AlexanderKoenig15/Komplexe-Leistung/Expose Vorlage.docx

Alexander König 11d 13.09.2021

Expose

Thema der Arbeit | Bemerkungen
Ziel der Arbeit
Arbeitsschritte mit Zeitplan
Inhaltliche Gliederung
Hinweise des Fachlehrers
Bestätigung des Fachlehrers
Datum und Unterschrift:
Datum:
Unterschrift:
