AlexanderKoenig15/Komplexe-Leistung/Modelle/Wandsensor Gehäuse.stl

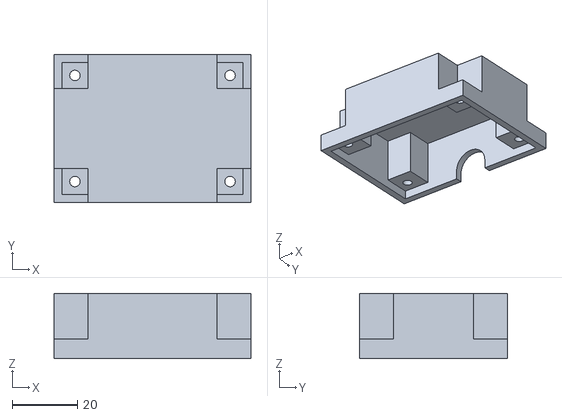
[picture p10: CAD file, 2022-01-17]
Modelle/Wandsensor Gehäuse.stl
60.3 x 45.3 x 20.0
