AlexanderKoenig15/Komplexe-Leistung/Modelle/Kabelklemme für 4 Pin Klemme.stl

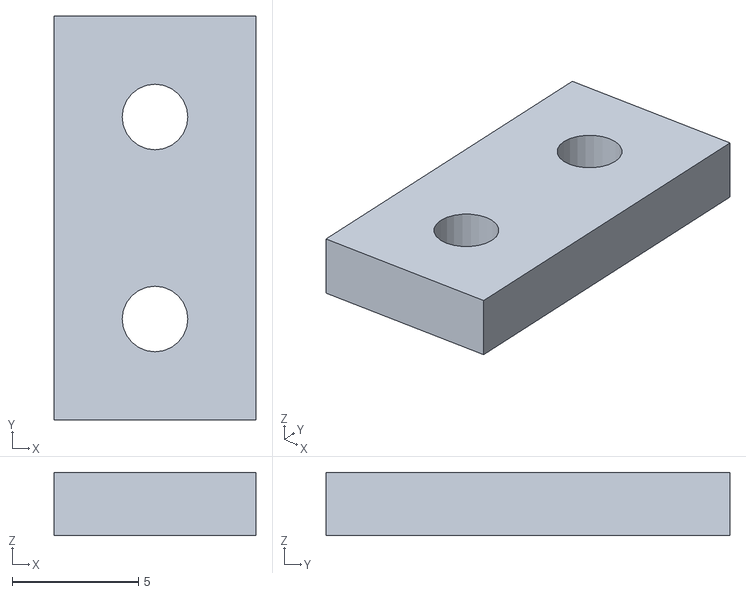
[picture p11: CAD file, 2022-01-10]
Modelle/Kabelklemme für 4 Pin Klemme.stl
8.00 x 16.0 x 2.50
