AlexanderKoenig15/Komplexe-Leistung/Modelle/Oberes Gehäuse.stl

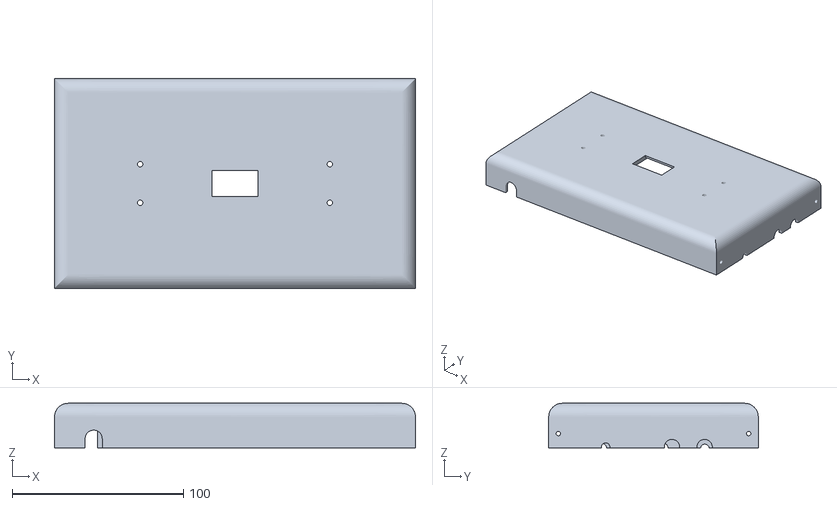
[picture p12: CAD file, 2022-01-10]
Modelle/Oberes Gehäuse.stl
210.8 x 122.4 x 26.0
