AlexanderKoenig15/Komplexe-Leistung/Modelle/Kabelklemme für 2 Pin Klemme.stl

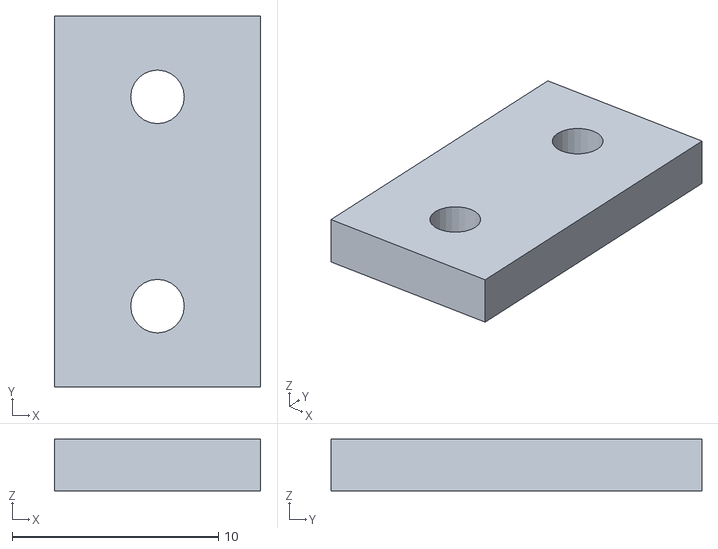
[picture p13: CAD file, 2022-01-10]
Modelle/Kabelklemme für 2 Pin Klemme.stl
10.0 x 18.0 x 2.50
