AlexanderKoenig15/Komplexe-Leistung/Modelle/Oberes Gehäuse Griff.stl

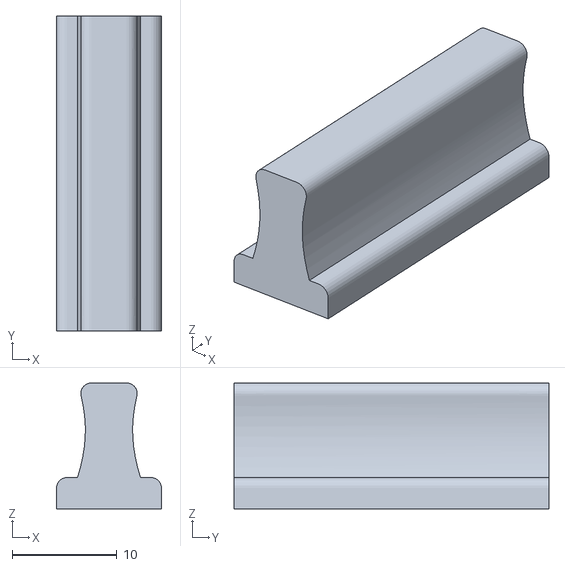
[picture p14: CAD file, 2022-01-10]
Modelle/Oberes Gehäuse Griff.stl
10.0 x 30.0 x 12.0
