AlexanderKoenig15/Komplexe-Leistung/Modelle/Unteres Gehäuse.stl

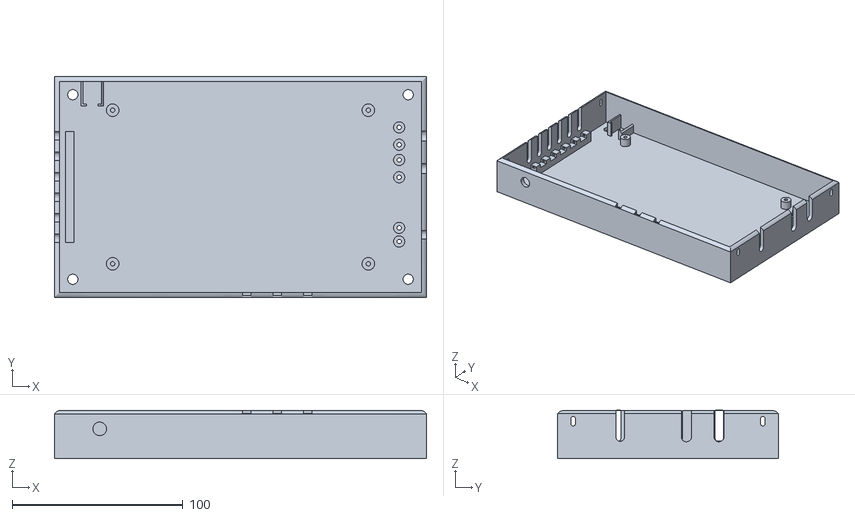
[picture p15: CAD file, 2022-01-10]
Modelle/Unteres Gehäuse.stl
218.0 x 129.6 x 28.2
