AlexanderKoenig15/Komplexe-Leistung/(list of files, cad)

Other CAD files:
Modelle/Kabelklemme für 2 Pin Klemme.dwg
Modelle/Kabelklemme für 4 Pin Klemme.dwg
Modelle/Oberes Gehäuse Griff.dwg
Modelle/Oberes Gehäuse.dwg
Modelle/Unteres Gehäuse.dwg
Modelle/Wandsensor Gehäuse.dwg
