AlexanderKoenig15/Komplexe-Leistung/Skizzen/Schaltplan/Schaltplan.kicad_pcb

## KiCad design Skizzen/Schaltplan/Schaltplan.kicad_pcb (2022-01-10)

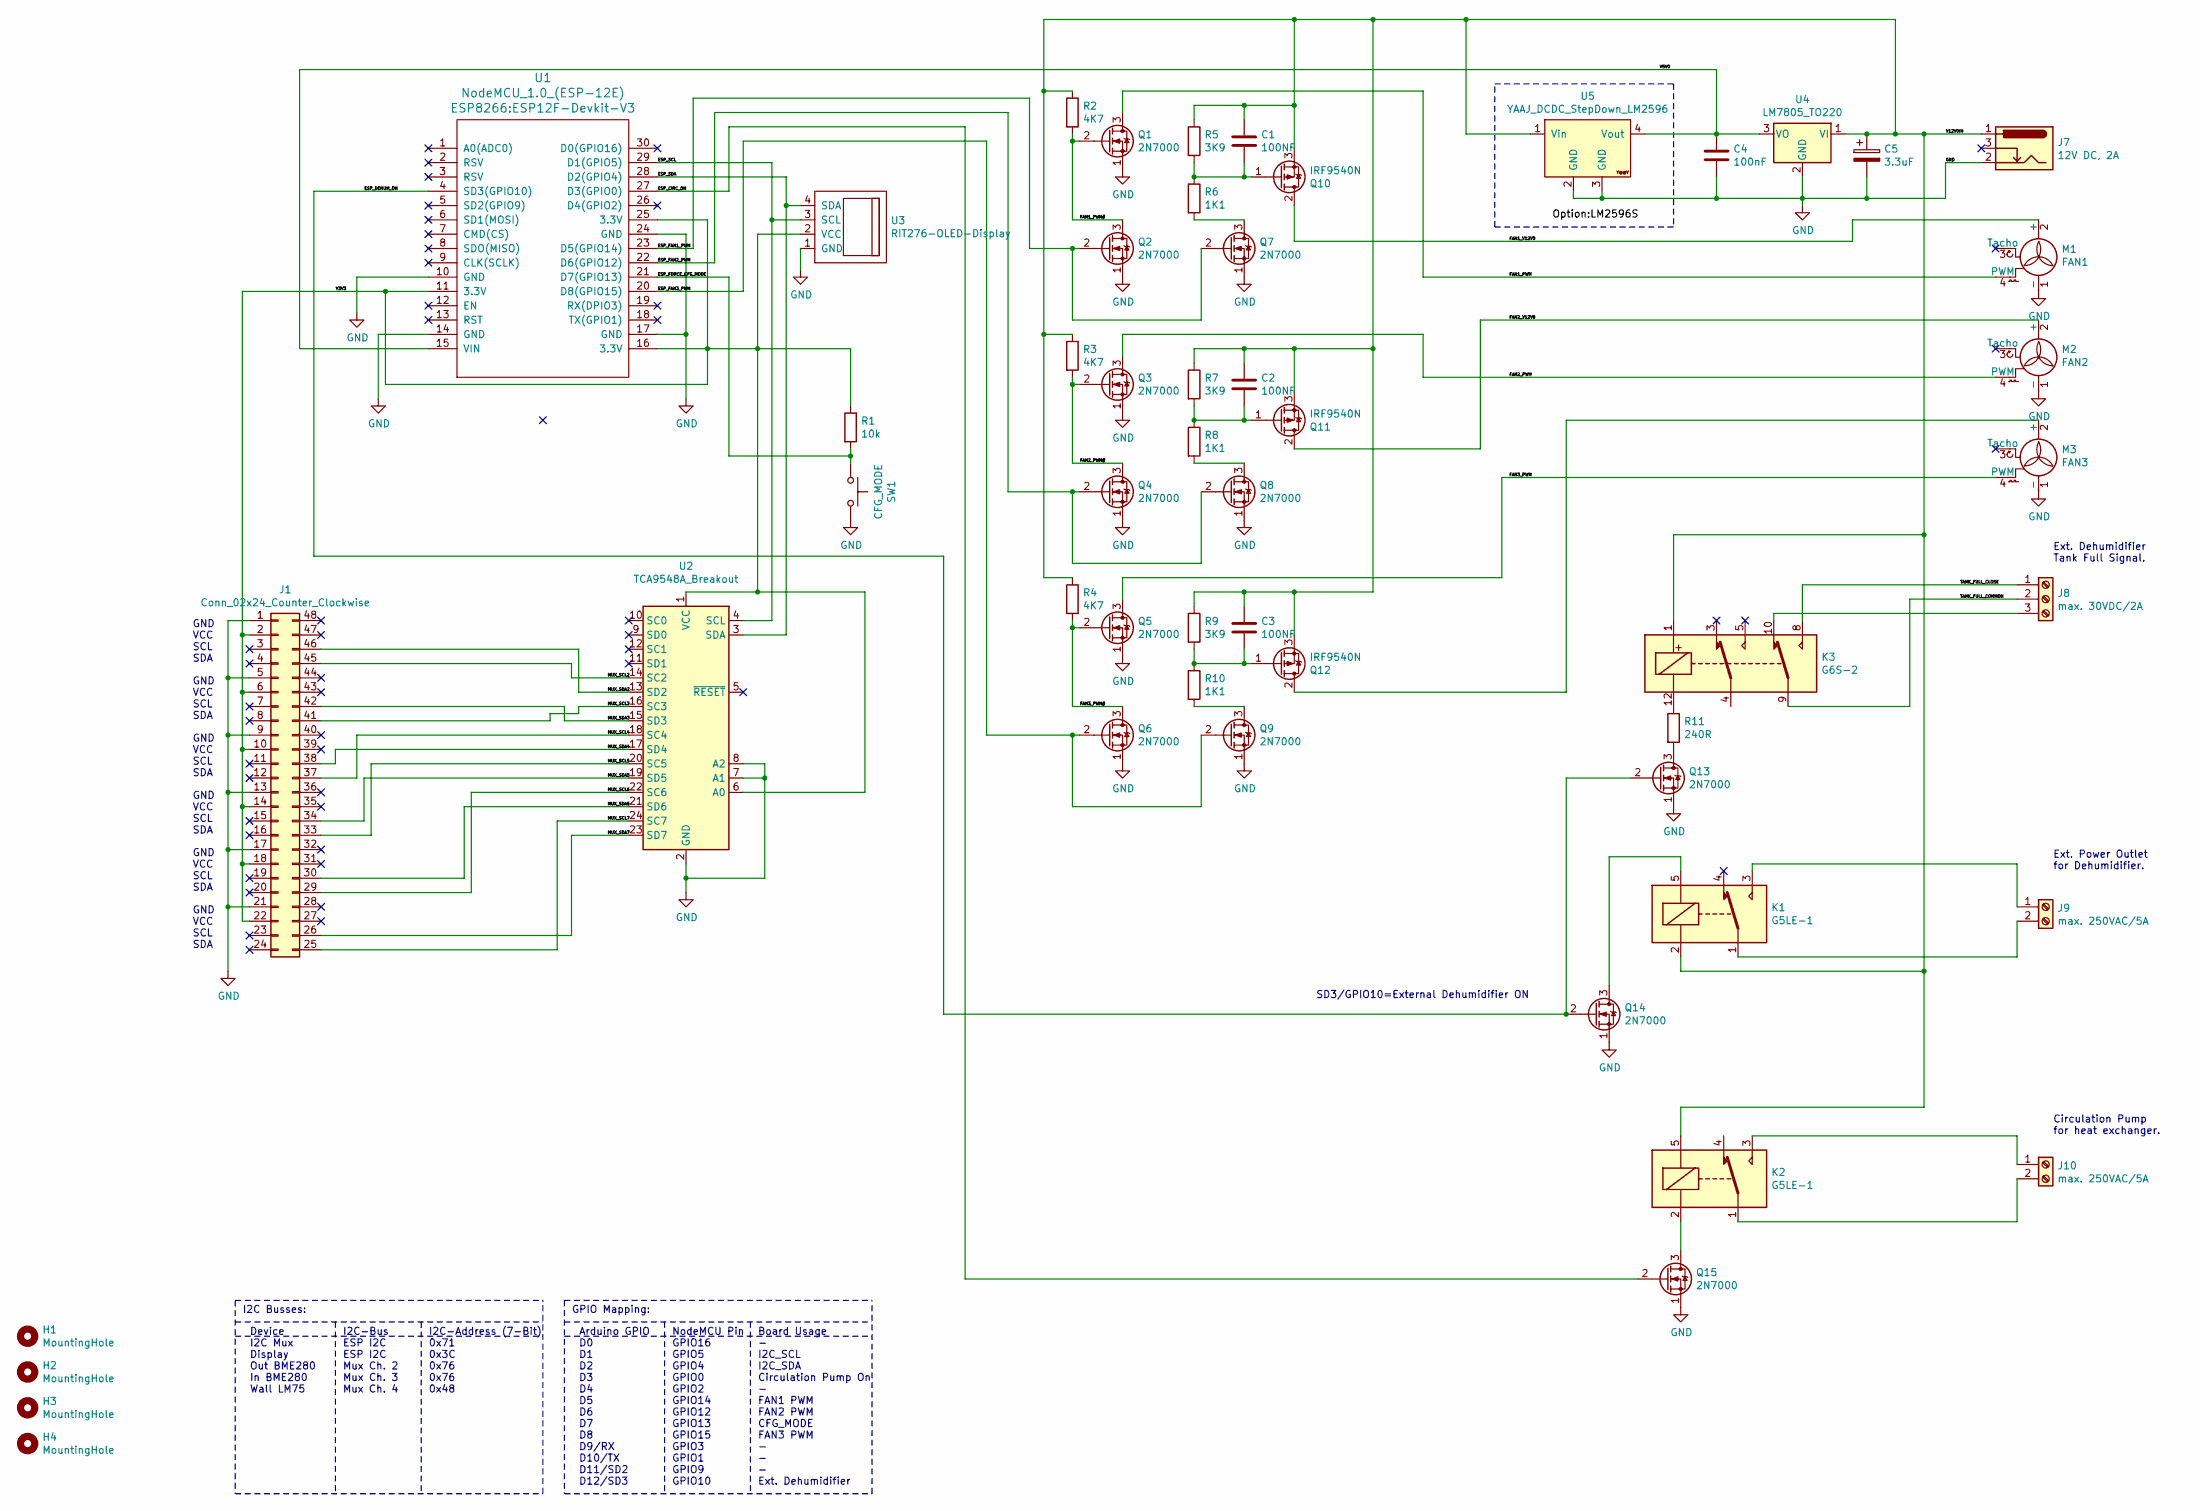
[picture p16: schematic Schaltplan.sch, Kellerlüftung mit ESP8266, Schaltplan]

Parts:
C1, C2, C3: 100NF; C_Disc_D4.3mm_W1.9mm_P5.00mm
C4: 100nF; C_Disc_D4.3mm_W1.9mm_P5.00mm
C5: 3.3uF; CP_Radial_Tantal_D4.5mm_P5.00mm
H1, H2, H3, H4: MountingHole; MountingHole_3.2mm_M3
J1: Conn_02x24_Counter_Clockwise; FFKDSH-2,54_24
J7: 12V DC, 2A; PinHeader_1x03_P2.54mm_Vertical
J8: max. 30VDC/2A; TerminalBlock_RND_205-00002_1x03_P5.00mm_Horizontal
J9, J10: max. 250VAC/5A; TerminalBlock_RND_205-00001_1x02_P5.00mm_Horizontal
K1, K2: G5LE-1; Relay_SPDT_Omron-G5LE-1
K3: G6S-2; Relay_DPDT_Omron_G6S-2
M1: FAN1; PinSocket_1x04_P2.54mm_Vertical
M2: FAN2; PinSocket_1x04_P2.54mm_Vertical
M3: FAN3; PinSocket_1x04_P2.54mm_Vertical
Q1, Q2, Q3, Q4, Q5, Q6, Q7, Q8, Q9, Q13, Q14, Q15: 2N7000; TO-92_Inline
Q10, Q11, Q12: IRF9540N; TO-220-3_Vertical
R1: 10k; R_Axial_DIN0204_L3.6mm_D1.6mm_P2.54mm_Vertical
R2, R3, R4: 4K7; R_Axial_DIN0204_L3.6mm_D1.6mm_P2.54mm_Vertical
R5, R7, R9: 3K9; R_Axial_DIN0204_L3.6mm_D1.6mm_P2.54mm_Vertical
R6, R8, R10: 1K1; R_Axial_DIN0204_L3.6mm_D1.6mm_P7.62mm_Horizontal
R11: 240R; R_Axial_DIN0204_L3.6mm_D1.6mm_P2.54mm_Vertical
SW1: CFG_MODE; PinHeader_1x02_P2.54mm_Vertical
U1: NodeMCU_1.0_(ESP-12E); ESP12F-Devkit-V3
U2: TCA9548A_Breakout
U3: RIT276-OLED-Display; SSD1306_128x64_0.96
U4: LM7805_TO220; TO-220-3_Vertical
U5: YAAJ_DCDC_StepDown_LM2596

Connections:
/ESP_CIRC_ON: Q15.2 (G), U1.27 (D3(GPIO0))
/ESP_DEHUM_ON: Q13.2 (G), Q14.2 (G), U1.4 (SD3(GPIO10))
/ESP_FAN1_PWM: Q2.2 (G), Q7.2 (G), U1.23 (D5(GPIO14))
/ESP_FAN2_PWM: Q4.2 (G), Q8.2 (G), U1.22 (D6(GPIO12))
/ESP_FAN3_PWM: Q6.2 (G), Q9.2 (G), U1.20 (D8(GPIO15))
/ESP_FORCE_CFG_MODE: R1.2, SW1.1, U1.21 (D7(GPIO13))
/ESP_SCL: U1.29 (D1(GPIO5)), U2.4 (SCL), U3.3 (SCL)
/ESP_SDA: U1.28 (D2(GPIO4)), U2.3 (SDA), U3.4 (SDA)
/FAN1_PWM: M1.4 (PWM), Q1.3 (D)
/FAN1_PWM#: Q1.2 (G), Q2.3 (D), R2.2
/FAN1_V12V0: M1.2 (+), Q10.2 (D)
/FAN2_PWM: M2.4 (PWM), Q3.3 (D)
/FAN2_PWM#: Q3.2 (G), Q4.3 (D), R3.2
/FAN2_V12V0: M2.2 (+), Q11.2 (D)
/FAN3_PWM: M3.4 (PWM), Q5.3 (D)
/FAN3_PWM#: Q5.2 (G), Q6.3 (D), R4.2
/MUX_SCL2: J1.45, U2.14 (SC2)
/MUX_SCL3: J1.41, U2.16 (SC3)
/MUX_SCL4: J1.37, U2.18 (SC4)
/MUX_SCL5: J1.33, U2.20 (SC5)
/MUX_SCL6: J1.29, U2.22 (SC6)
/MUX_SCL7: J1.25, U2.24 (SC7)
/MUX_SDA2: J1.46, U2.13 (SD2)
/MUX_SDA3: J1.42, U2.15 (SD3)
/MUX_SDA4: J1.38, U2.17 (SD4)
/MUX_SDA5: J1.34, U2.19 (SD5)
/MUX_SDA6: J1.30, U2.21 (SD6)
/MUX_SDA7: J1.26, U2.23 (SD7)
/TANK_FULL_CLOSE: J8.1, K3.8
/TANK_FULL_COMMON: J8.2, K3.9
/V3V3: J1.2, J1.6, J1.10, J1.14, J1.18, J1.22, R1.1, U1.11 (3.3V), U1.16 (3.3V), U1.25 (3.3V), U2.1 (VCC), U2.6 (A0), U3.2 (VCC)
/V5V0: C4.1, U1.15 (VIN), U4.3 (VO), U5.4 (Vout)
/V12V0IN: C1.1, C2.1, C3.1, C5.1, J7.1, K1.2, K2.5, K3.1, Q10.3 (S), Q11.3 (S), Q12.3 (S), R2.1, R3.1, R4.1, R5.1, R7.1, R9.1, U4.1 (VI), U5.1 (Vin)
GND: C4.2, C5.2, J1.1, J1.5, J1.9, J1.13, J1.17, J1.21, J7.2, M1.1 (-), M2.1 (-), M3.1 (-), Q1.1 (S), Q2.1 (S), Q3.1 (S), Q4.1 (S), Q5.1 (S), Q6.1 (S), Q7.1 (S), Q8.1 (S), Q9.1 (S), Q13.1 (S), Q14.1 (S), Q15.1 (S), SW1.2, U1.10 (GND), U1.14 (GND), U1.17 (GND), U1.24 (GND), U2.2 (GND), U2.7 (A1), U2.8 (A2), U3.1 (GND), U4.2 (GND), U5.2 (GND), U5.3 (GND)
unnamed: C1.2, Q10.1 (G), R5.2, R6.1
unnamed: C2.2, Q11.1 (G), R7.2, R8.1
unnamed: C3.2, Q12.1 (G), R9.2, R10.1
unnamed: J8.3, K3.10
unnamed: J9.1, K1.3
unnamed: J9.2, K1.1
unnamed: J10.1, K2.3
unnamed: J10.2, K2.1
unnamed: K1.5, Q14.3 (D)
unnamed: K2.2, Q15.3 (D)
unnamed: K3.12, R11.1
unnamed: M3.2 (+), Q12.2 (D)
unnamed: Q7.3 (D), R6.2
unnamed: Q8.3 (D), R8.2
unnamed: Q9.3 (D), R10.2
unnamed: Q13.3 (D), R11.2

Notes on the sheet:
SD3/GPIO10=External Dehumidifier ON
Ext. Power Outlet for Dehumidifier.
Ext. Dehumidifier Tank Full Signal.
Circulation Pump for heat exchanger.
GPIO Mapping:
Arduino GPIO D0 D1 D2 D3 D4 D5 D6 D7 D8 D9/RX D10/TX D11/SD2 D12/SD3
NodeMCU Pin GPIO16 GPIO5 GPIO4 GPIO0 GPIO2 GPIO14 GPIO12 GPIO13 GPIO15 GPIO3 GPIO1 GPIO9 GPIO10
Board Usage - I2C_SCL I2C_SDA Circulation Pump On - FAN1 PWM FAN2 PWM CFG_MODE FAN3 PWM - - - Ext. Dehumidifier
GND VCC SCL SDA
I2C Busses:
I2C-Bus ESP I2C ESP I2C Mux Ch. 2 Mux Ch. 3 Mux Ch. 4
Device I2C Mux Display Out BME280 In BME280 Wall LM75
I2C-Address (7-Bit) 0x71 0x3C 0x76 0x76 0x48

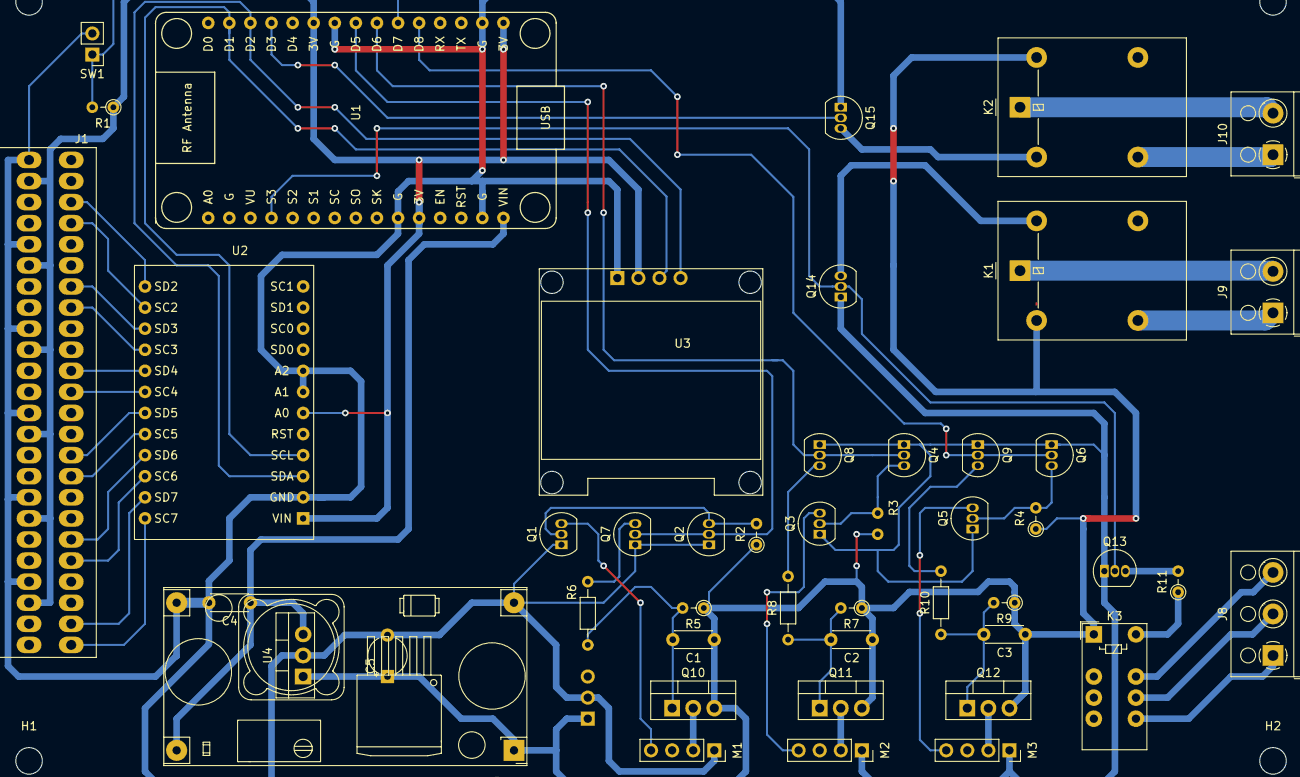
[picture p17: board Schaltplan.kicad_pcb from above]

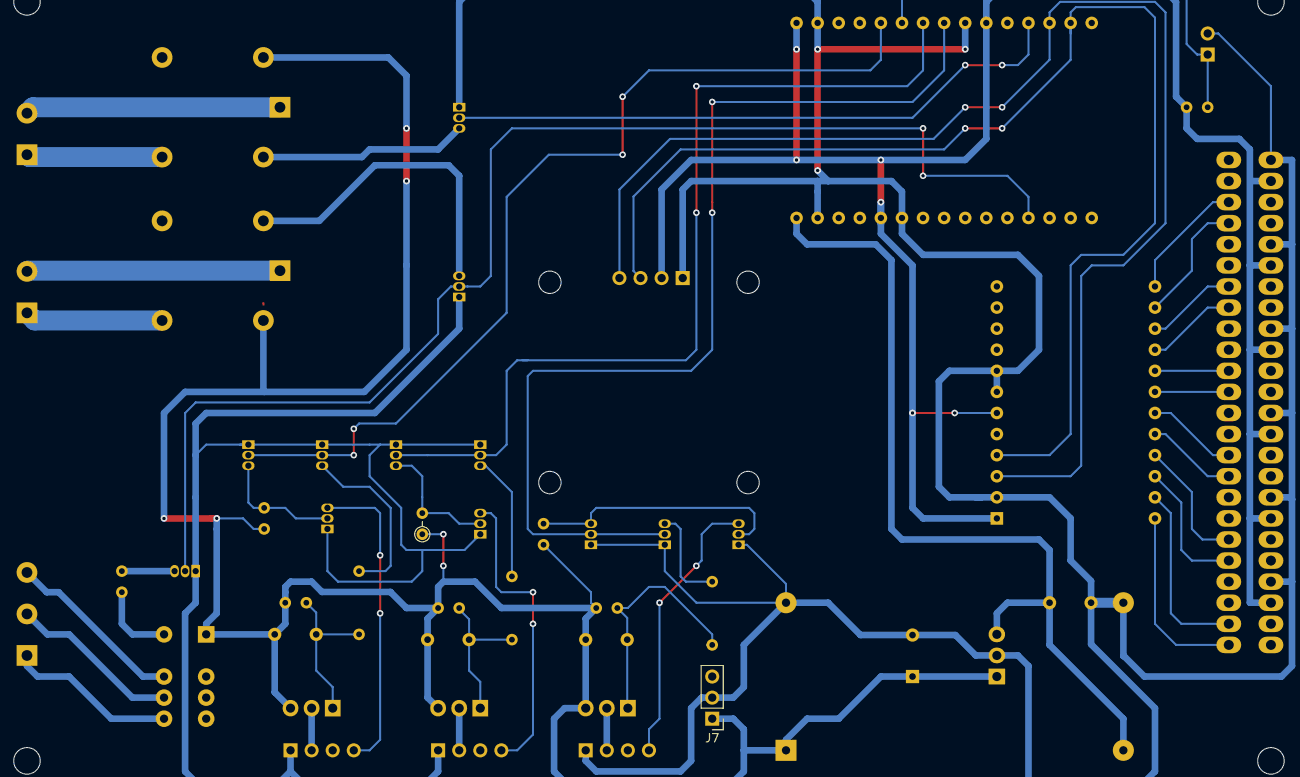
[picture p18: board Schaltplan.kicad_pcb from below]

Board: 2 copper layers, 52 parts (2 on the bottom side), 50 nets.
