AlexanderKoenig15/Komplexe-Leistung/(commit log)

2021-08-30 Woche 1 22.80.2021 - 29.8.2021
    [Schaltplan.kicad_pcb, Schaltplan.sch]
2021-09-06 Woche 2 29.09.2021 - 05.09.2021
    -Code fertig
    [Schaltplan.sch]
2021-09-20 Woche 4 13.09.2021-20.09.2021
    [Schaltplan.sch]
2021-09-27 Woche 5 19.09.2021 - 26.09.2021
    [Gehäuse.blend, Schaltplan.sch]
2021-10-05 Woche 6 26.09.2021 - 01.10.2021
    [Gehäuse.blend]
2021-10-11 Woche 7 01.10.2021 - 03.10.2021
    [Schaltplan.sch]
2021-10-18 Woche 8 10.10.2021 - 17.10.2021
    [Schaltplan.kicad_pcb, Schaltplan.sch]
2021-10-25 Woche 9 17.10.2021 - 24.10.2021
    [Schaltplan.kicad_pcb, Schaltplan.sch]
2022-01-10 Woche 20 02.01.2022 - 08.01.2022
    [Gehäuse BME280 v3.stl, Gehäuse.blend, Kabelklemme für 2 Pin Klemme.dwg, Kabelklemme für 2 Pin Klemme.stl, Kabelklemme für 4 Pin Klemme.dwg, Kabelklemme für 4 Pin Klemme.stl, Oberes Gehäuse Griff.dwg, Oberes Gehäuse Griff.stl]
2022-01-17 Woche 21 09.01.2022 - 16.01.2022
    [Gehäuse BME280 v3.stl, Wandsensor Gehäuse.dwg, Wandsensor Gehäuse.stl]
